eteq/magkeyboard/color_tests_inverted.png

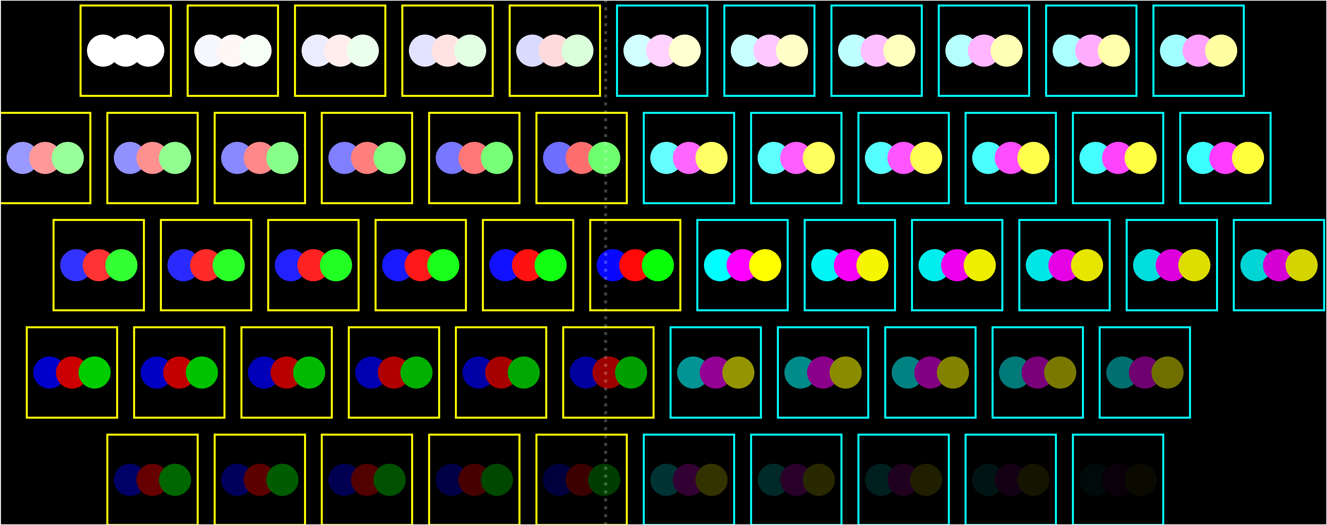
color_tests_inverted.png
