eteq/magkeyboard/color_tests.png

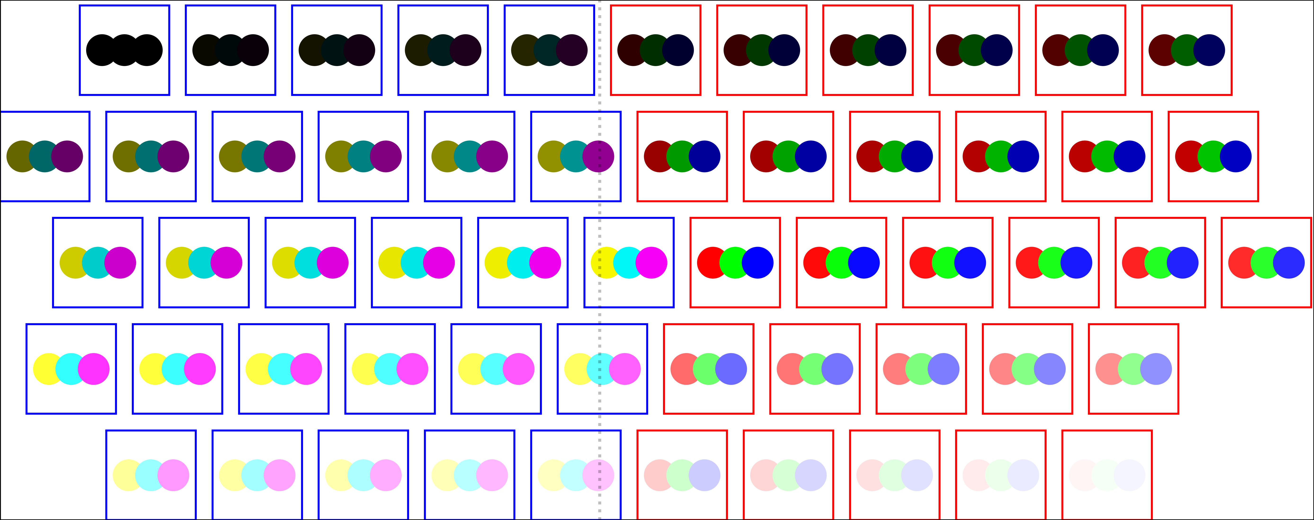
color_tests.png
