eteq/magkeyboard/keyboard_layout.png

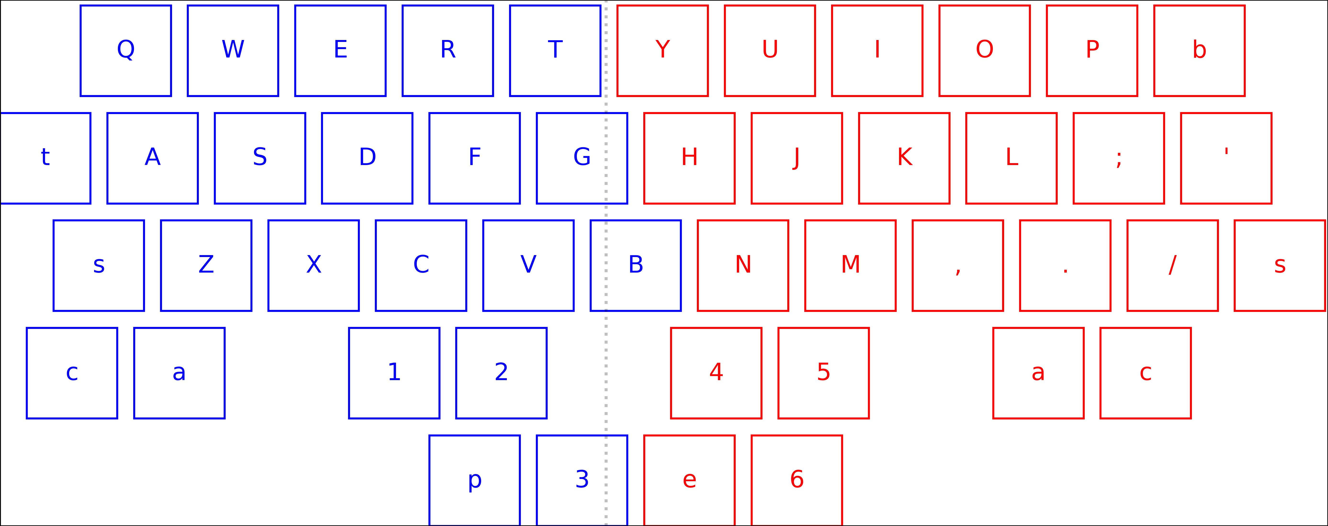
keyboard_layout.png
