eteq/magkeyboard/maghand/maghand.kicad_pcb

## KiCad design maghand/maghand.kicad_pcb (2025-11-02)

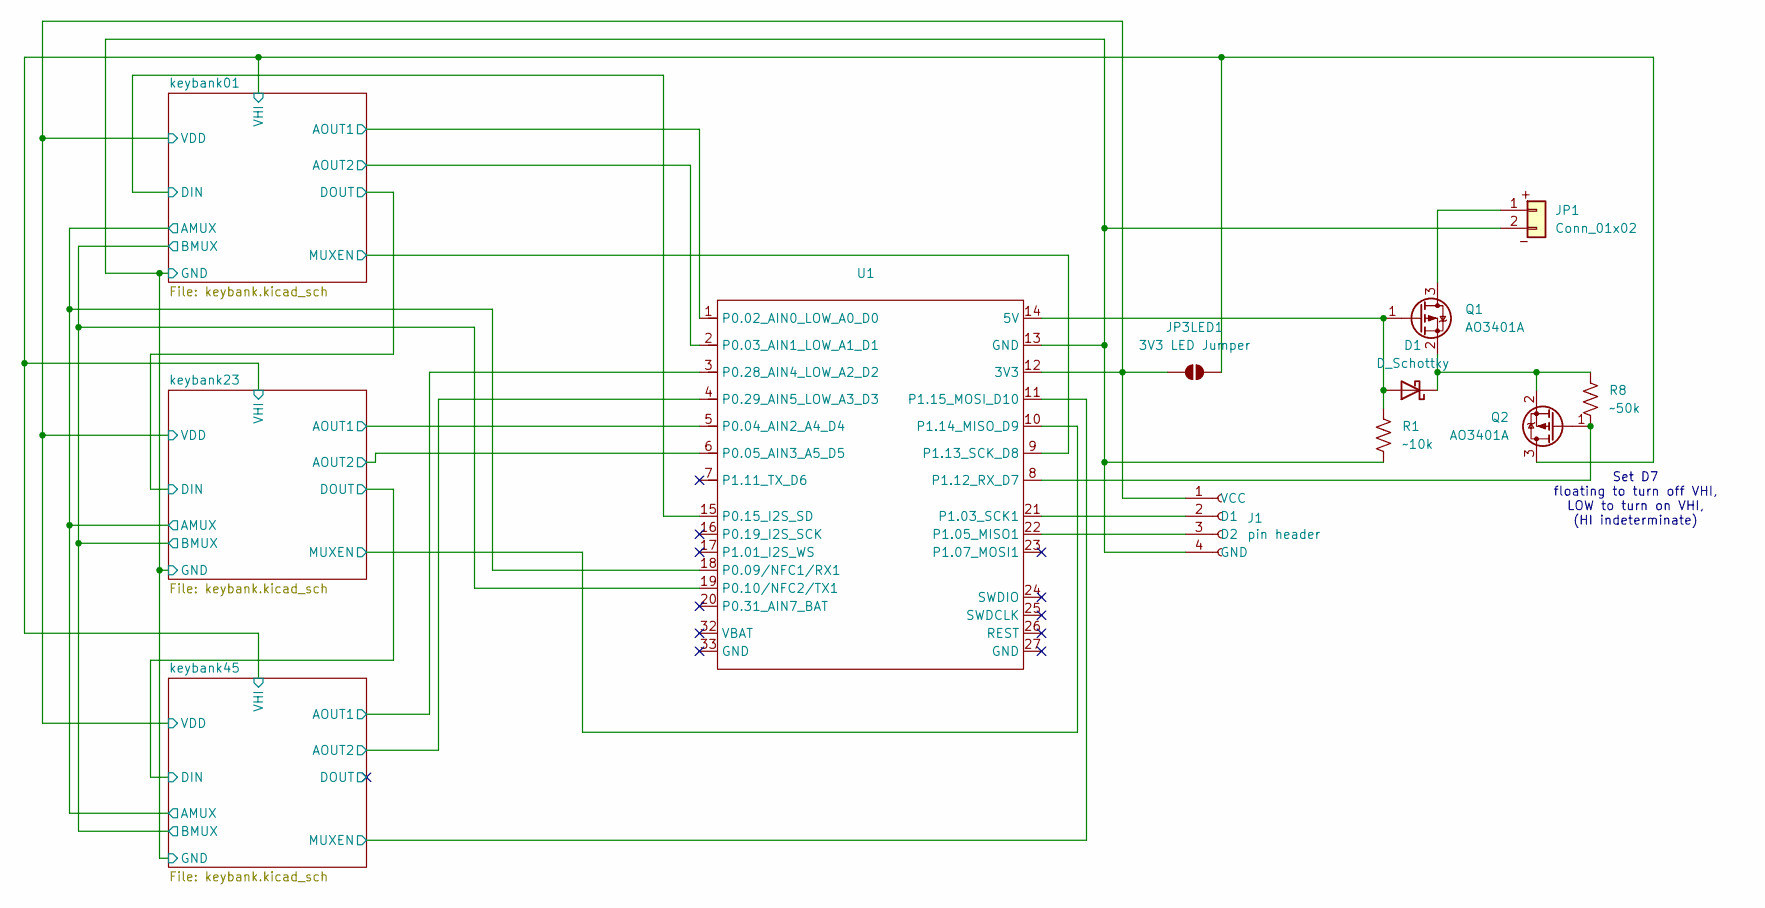
[picture p4: schematic maghand.kicad_sch]

Parts:
D1: D_Schottky; D_Powermite_AK
J1: pin header; PinSocket_1x04_P2.54mm_Vertical
JP1: Conn_01x02; JST_PH_S2B-PH-SM4-TB_1x02-1MP_P2.00mm_Horizontal
JP3LED1: 3V3 LED Jumper; SolderJumper-2_P1.3mm_Open_TrianglePad1.0x1.5mm
Q1, Q2: AO3401A; SOT-23
R1: ~10k; R_0805_2012Metric_Pad1.20x1.40mm_HandSolder
R8: ~50k; R_0805_2012Metric_Pad1.20x1.40mm_HandSolder
U1: XIAO-nRF52840-Plus-SMD_bathole

Connections:
/keybank01/AMUX: U1.18 (P0.09/NFC1/RX1); also elsewhere on the board
/keybank01/AOUT1: U1.1 (P0.02_AIN0_LOW_A0_D0); also elsewhere on the board
/keybank01/AOUT2: U1.2 (P0.03_AIN1_LOW_A1_D1); also elsewhere on the board
/keybank01/BMUX: U1.19 (P0.10/NFC2/TX1); also elsewhere on the board
/keybank01/DIN: U1.15 (P0.15_I2S_SD); also elsewhere on the board
/keybank01/GND: J1.4 (GND), JP1.2 (BAT-), R1.2, U1.13 (GND); also elsewhere on the board
/keybank01/MUXEN: U1.9 (P1.13_SCK_D8); also elsewhere on the board
/keybank01/VDD: J1.1 (VCC), JP3LED1.2 (B), U1.12 (3V3); also elsewhere on the board
/keybank01/VHI: JP3LED1.1 (A), Q2.3 (D); also elsewhere on the board
/keybank23/AOUT1: U1.5 (P0.04_AIN2_A4_D4); also elsewhere on the board
/keybank23/AOUT2: U1.6 (P0.05_AIN3_A5_D5); also elsewhere on the board
/keybank23/MUXEN: U1.10 (P1.14_MISO_D9); also elsewhere on the board
/keybank45/AOUT1: U1.3 (P0.28_AIN4_LOW_A2_D2); also elsewhere on the board
/keybank45/AOUT2: U1.4 (P0.29_AIN5_LOW_A3_D3); also elsewhere on the board
/keybank45/MUXEN: U1.11 (P1.15_MOSI_D10); also elsewhere on the board
unnamed: D1.2 (A), Q1.1 (G), R1.1, U1.14 (5V)
unnamed: D1.1 (K), Q1.2 (S), Q2.2 (S), R8.1
unnamed: J1.2 (D1), U1.21 (P1.03_SCK1)
unnamed: J1.3 (D2), U1.22 (P1.05_MISO1)
unnamed: JP1.1 (BAT+), Q1.3 (D)
unnamed: Q2.1 (G), R8.2, U1.8 (P1.12_RX_D7)

Notes on the sheet:
Set D7 floating to turn off VHI, LOW to turn on VHI, (HI indeterminate)

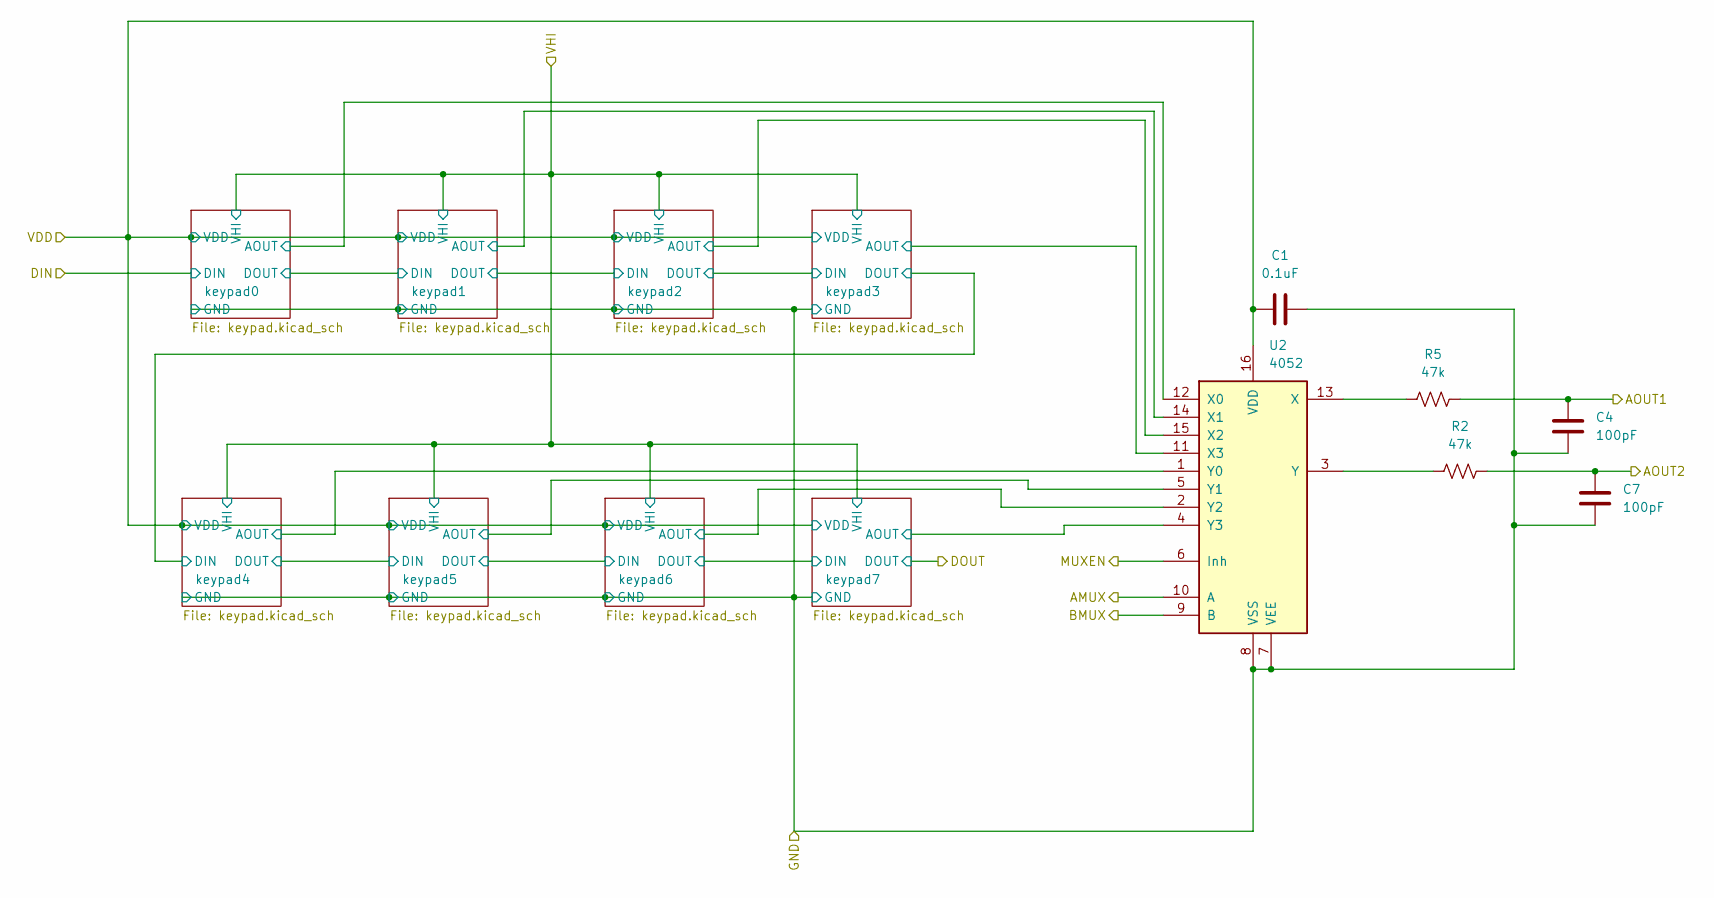
[picture p5: schematic keybank.kicad_sch, Key bank]

Parts:
C1: 0.1uF; C_0805_2012Metric_Pad1.18x1.45mm_HandSolder
C4, C7: 100pF; C_0805_2012Metric_Pad1.18x1.45mm_HandSolder
R2, R5: 47k; R_0805_2012Metric_Pad1.20x1.40mm_HandSolder
U2: 4052; SOIC-16_3.9x9.9mm_P1.27mm

Connections:
/keybank01/AMUX: U2.10 (A); also elsewhere on the board
/keybank01/AOUT1: C4.1, R5.2; also elsewhere on the board
/keybank01/AOUT2: C7.1, R2.2; also elsewhere on the board
/keybank01/BMUX: U2.9 (B); also elsewhere on the board
/keybank01/GND: C1.1, C4.2, C7.2, U2.7 (VEE), U2.8 (VSS); also elsewhere on the board
/keybank01/MUXEN: U2.6 (Inh); also elsewhere on the board
/keybank01/VDD: C1.2, U2.16 (VDD); also elsewhere on the board
/keybank01/keypad0/AOUT: U2.12 (X0); also elsewhere on the board
/keybank01/keypad1/AOUT: U2.14 (X1); also elsewhere on the board
/keybank01/keypad2/AOUT: U2.15 (X2); also elsewhere on the board
/keybank01/keypad3/AOUT: U2.11 (X3); also elsewhere on the board
/keybank01/keypad4/AOUT: U2.1 (Y0); also elsewhere on the board
/keybank01/keypad5/AOUT: U2.5 (Y1); also elsewhere on the board
/keybank01/keypad6/AOUT: U2.2 (Y2); also elsewhere on the board
/keybank01/keypad7/AOUT: U2.4 (Y3); also elsewhere on the board
unnamed: R5.1, U2.13 (X)
unnamed: R2.1, U2.3 (Y)

Parts of its further copies:
C2, C3: 0.1uF; C_0805_2012Metric_Pad1.18x1.45mm_HandSolder
C5, C6, C8, C9: 100pF; C_0805_2012Metric_Pad1.18x1.45mm_HandSolder
R3, R4, R6, R7: 47k; R_0805_2012Metric_Pad1.20x1.40mm_HandSolder
U3, U4: 4052; SOIC-16_3.9x9.9mm_P1.27mm

Connections of its further copies:
/keybank01/AMUX: U3.10 (A), U4.10 (A); also elsewhere on the board
/keybank01/BMUX: U3.9 (B), U4.9 (B); also elsewhere on the board
/keybank01/GND: C2.1, C3.1, C5.2, C6.2, C8.2, C9.2, U3.7 (VEE), U3.8 (VSS), U4.7 (VEE), U4.8 (VSS); also elsewhere on the board
/keybank01/VDD: C2.2, C3.2, U3.16 (VDD), U4.16 (VDD); also elsewhere on the board
/keybank23/AOUT1: C5.1, R6.2; also elsewhere on the board
/keybank23/AOUT2: C8.1, R3.2; also elsewhere on the board
/keybank23/MUXEN: U3.6 (Inh); also elsewhere on the board
/keybank23/keypad0/AOUT: U3.12 (X0); also elsewhere on the board
/keybank23/keypad1/AOUT: U3.14 (X1); also elsewhere on the board
/keybank23/keypad2/AOUT: U3.15 (X2); also elsewhere on the board
/keybank23/keypad3/AOUT: U3.11 (X3); also elsewhere on the board
/keybank23/keypad4/AOUT: U3.1 (Y0); also elsewhere on the board
/keybank23/keypad5/AOUT: U3.5 (Y1); also elsewhere on the board
/keybank23/keypad6/AOUT: U3.2 (Y2); also elsewhere on the board
/keybank23/keypad7/AOUT: U3.4 (Y3); also elsewhere on the board
/keybank45/AOUT1: C6.1, R7.2; also elsewhere on the board
/keybank45/AOUT2: C9.1, R4.2; also elsewhere on the board
/keybank45/MUXEN: U4.6 (Inh); also elsewhere on the board
/keybank45/keypad0/AOUT: U4.12 (X0); also elsewhere on the board
/keybank45/keypad1/AOUT: U4.14 (X1); also elsewhere on the board
/keybank45/keypad2/AOUT: U4.15 (X2); also elsewhere on the board
/keybank45/keypad3/AOUT: U4.11 (X3); also elsewhere on the board
/keybank45/keypad4/AOUT: U4.1 (Y0); also elsewhere on the board
/keybank45/keypad5/AOUT: U4.5 (Y1); also elsewhere on the board
/keybank45/keypad6/AOUT: U4.2 (Y2); also elsewhere on the board
/keybank45/keypad7/AOUT: U4.4 (Y3)
unnamed: R6.1, U3.13 (X)
unnamed: R3.1, U3.3 (Y)
unnamed: R7.1, U4.13 (X)
unnamed: R4.1, U4.3 (Y)

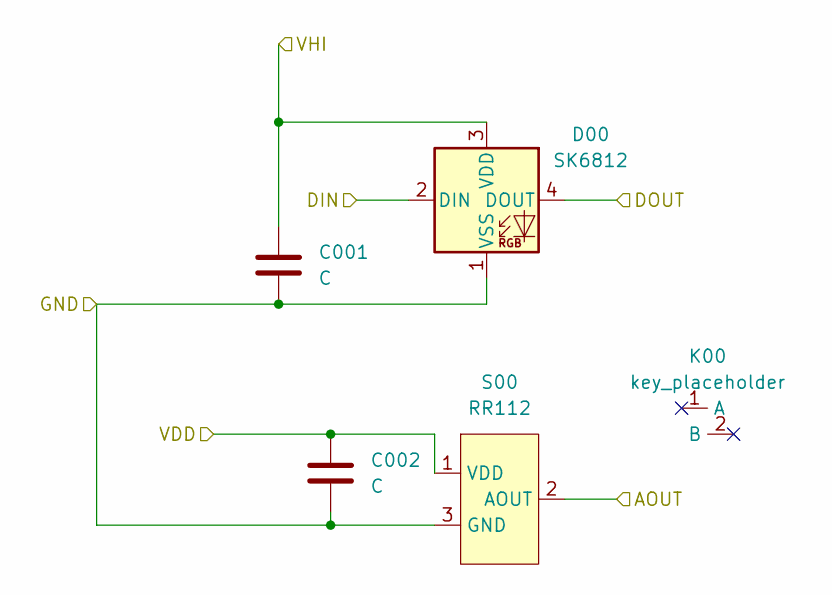
[picture p6: schematic keypad.kicad_sch, key subschematic]

Parts:
C001, C002: C; C_0805_2012Metric_Pad1.18x1.45mm_HandSolder
D00: SK6812; LED_SK6812_PLCC4_5.0x5.0mm_P3.2mm
K00: key_placeholder; Key Holder
S00: RR112; SOT-23_Handsoldering

Connections:
/keybank01/DIN: D00.2 (DIN); also elsewhere on the board
/keybank01/GND: C001.2, C002.2, D00.1 (VSS), S00.3 (GND); also elsewhere on the board
/keybank01/VDD: C002.1, S00.1 (VDD); also elsewhere on the board
/keybank01/VHI: C001.1, D00.3 (VDD); also elsewhere on the board
/keybank01/keypad0/AOUT: S00.2 (AOUT); also elsewhere on the board
/keybank01/keypad0/DOUT: D00.4 (DOUT); also elsewhere on the board

Parts of its further copies:
C011, C012, C021, C022, C031, C032, C101, C102, C111, C112, C121, C122, C131, C132, C201, C202, C211, C212, C221, C222, C231, C232, C301, C302, C311, C312, C321, C322, C331, C332, C401, C402, C411, C412, C421, C422, C431, C432, C501, C502, C511, C512, C521, C522: C; C_0805_2012Metric_Pad1.18x1.45mm_HandSolder
D01, D02, D03, D10, D11, D12, D13, D20, D21, D22, D23, D30, D31, D32, D33, D40, D41, D42, D43, D50, D51, D52: SK6812; LED_SK6812_PLCC4_5.0x5.0mm_P3.2mm
K01, K02, K03, K10, K11, K12, K13, K20, K21, K22, K23, K30, K31, K32, K33, K40, K41, K42, K43, K50, K51, K52: key_placeholder; Key Holder
S01, S02, S03, S10, S11, S12, S13, S20, S21, S22, S23, S30, S31, S32, S33, S40, S41, S42, S43, S50, S51, S52: RR112; SOT-23_Handsoldering

Connections of its further copies:
/keybank01/DOUT: D13.4 (DOUT), D20.2 (DIN)
/keybank01/GND: C011.2, C012.2, C021.2, C022.2, C031.2, C032.2, C101.2, C102.2, C111.2, C112.2, C121.2, C122.2, C131.2, C132.2, C201.2, C202.2, C211.2, C212.2, C221.2, C222.2, C231.2, C232.2, C301.2, C302.2, C311.2, C312.2, C321.2, C322.2, C331.2, C332.2, C401.2, C402.2, C411.2, C412.2, C421.2, C422.2, C431.2, C432.2, C501.2, C502.2, C511.2, C512.2, C521.2, C522.2, D01.1 (VSS), D02.1 (VSS), D03.1 (VSS), D10.1 (VSS), D11.1 (VSS), D12.1 (VSS), D13.1 (VSS), D20.1 (VSS), D21.1 (VSS), D22.1 (VSS), D23.1 (VSS), D30.1 (VSS), D31.1 (VSS), D32.1 (VSS), D33.1 (VSS), D40.1 (VSS), D41.1 (VSS), D42.1 (VSS), D43.1 (VSS), D50.1 (VSS), D51.1 (VSS), D52.1 (VSS), S01.3 (GND), S02.3 (GND), S03.3 (GND), S10.3 (GND), S11.3 (GND), S12.3 (GND), S13.3 (GND), S20.3 (GND), S21.3 (GND), S22.3 (GND), S23.3 (GND), S30.3 (GND), S31.3 (GND), S32.3 (GND), S33.3 (GND), S40.3 (GND), S41.3 (GND), S42.3 (GND), S43.3 (GND), S50.3 (GND), S51.3 (GND), S52.3 (GND); also elsewhere on the board
/keybank01/VDD: C012.1, C022.1, C032.1, C102.1, C112.1, C122.1, C132.1, C202.1, C212.1, C222.1, C232.1, C302.1, C312.1, C322.1, C332.1, C402.1, C412.1, C422.1, C432.1, C502.1, C512.1, C522.1, S01.1 (VDD), S02.1 (VDD), S03.1 (VDD), S10.1 (VDD), S11.1 (VDD), S12.1 (VDD), S13.1 (VDD), S20.1 (VDD), S21.1 (VDD), S22.1 (VDD), S23.1 (VDD), S30.1 (VDD), S31.1 (VDD), S32.1 (VDD), S33.1 (VDD), S40.1 (VDD), S41.1 (VDD), S42.1 (VDD), S43.1 (VDD), S50.1 (VDD), S51.1 (VDD), S52.1 (VDD); also elsewhere on the board
/keybank01/VHI: C011.1, C021.1, C031.1, C101.1, C111.1, C121.1, C131.1, C201.1, C211.1, C221.1, C231.1, C301.1, C311.1, C321.1, C331.1, C401.1, C411.1, C421.1, C431.1, C501.1, C511.1, C521.1, D01.3 (VDD), D02.3 (VDD), D03.3 (VDD), D10.3 (VDD), D11.3 (VDD), D12.3 (VDD), D13.3 (VDD), D20.3 (VDD), D21.3 (VDD), D22.3 (VDD), D23.3 (VDD), D30.3 (VDD), D31.3 (VDD), D32.3 (VDD), D33.3 (VDD), D40.3 (VDD), D41.3 (VDD), D42.3 (VDD), D43.3 (VDD), D50.3 (VDD), D51.3 (VDD), D52.3 (VDD); also elsewhere on the board
/keybank01/keypad0/DOUT: D01.2 (DIN); also elsewhere on the board
/keybank01/keypad1/AOUT: S01.2 (AOUT); also elsewhere on the board
/keybank01/keypad1/DOUT: D01.4 (DOUT), D02.2 (DIN)
/keybank01/keypad2/AOUT: S02.2 (AOUT); also elsewhere on the board
/keybank01/keypad2/DOUT: D02.4 (DOUT), D03.2 (DIN)
/keybank01/keypad3/AOUT: S03.2 (AOUT); also elsewhere on the board
/keybank01/keypad3/DOUT: D03.4 (DOUT), D10.2 (DIN)
/keybank01/keypad4/AOUT: S10.2 (AOUT); also elsewhere on the board
/keybank01/keypad4/DOUT: D10.4 (DOUT), D11.2 (DIN)
/keybank01/keypad5/AOUT: S11.2 (AOUT); also elsewhere on the board
/keybank01/keypad5/DOUT: D11.4 (DOUT), D12.2 (DIN)
/keybank01/keypad6/AOUT: S12.2 (AOUT); also elsewhere on the board
/keybank01/keypad6/DOUT: D12.4 (DOUT), D13.2 (DIN)
/keybank01/keypad7/AOUT: S13.2 (AOUT); also elsewhere on the board
/keybank23/DOUT: D33.4 (DOUT), D40.2 (DIN)
/keybank23/keypad0/AOUT: S20.2 (AOUT); also elsewhere on the board
/keybank23/keypad0/DOUT: D20.4 (DOUT), D21.2 (DIN)
/keybank23/keypad1/AOUT: S21.2 (AOUT); also elsewhere on the board
/keybank23/keypad1/DOUT: D21.4 (DOUT), D22.2 (DIN)
/keybank23/keypad2/AOUT: S22.2 (AOUT); also elsewhere on the board
/keybank23/keypad2/DOUT: D22.4 (DOUT), D23.2 (DIN)
/keybank23/keypad3/AOUT: S23.2 (AOUT); also elsewhere on the board
/keybank23/keypad3/DOUT: D23.4 (DOUT), D30.2 (DIN)
/keybank23/keypad4/AOUT: S30.2 (AOUT); also elsewhere on the board
/keybank23/keypad4/DOUT: D30.4 (DOUT), D31.2 (DIN)
/keybank23/keypad5/AOUT: S31.2 (AOUT); also elsewhere on the board
/keybank23/keypad5/DOUT: D31.4 (DOUT), D32.2 (DIN)
/keybank23/keypad6/AOUT: S32.2 (AOUT); also elsewhere on the board
/keybank23/keypad6/DOUT: D32.4 (DOUT), D33.2 (DIN)
/keybank23/keypad7/AOUT: S33.2 (AOUT); also elsewhere on the board
/keybank45/keypad0/AOUT: S40.2 (AOUT); also elsewhere on the board
/keybank45/keypad0/DOUT: D40.4 (DOUT), D41.2 (DIN)
/keybank45/keypad1/AOUT: S41.2 (AOUT); also elsewhere on the board
/keybank45/keypad1/DOUT: D41.4 (DOUT), D42.2 (DIN)
/keybank45/keypad2/AOUT: S42.2 (AOUT); also elsewhere on the board
/keybank45/keypad2/DOUT: D42.4 (DOUT), D43.2 (DIN)
/keybank45/keypad3/AOUT: S43.2 (AOUT); also elsewhere on the board
/keybank45/keypad3/DOUT: D43.4 (DOUT), D50.2 (DIN)
/keybank45/keypad4/AOUT: S50.2 (AOUT); also elsewhere on the board
/keybank45/keypad4/DOUT: D50.4 (DOUT), D51.2 (DIN)
/keybank45/keypad5/AOUT: S51.2 (AOUT); also elsewhere on the board
/keybank45/keypad5/DOUT: D51.4 (DOUT), D52.2 (DIN)
/keybank45/keypad6/AOUT: S52.2 (AOUT); also elsewhere on the board
/keybank45/keypad6/DOUT: D52.4 (DOUT)

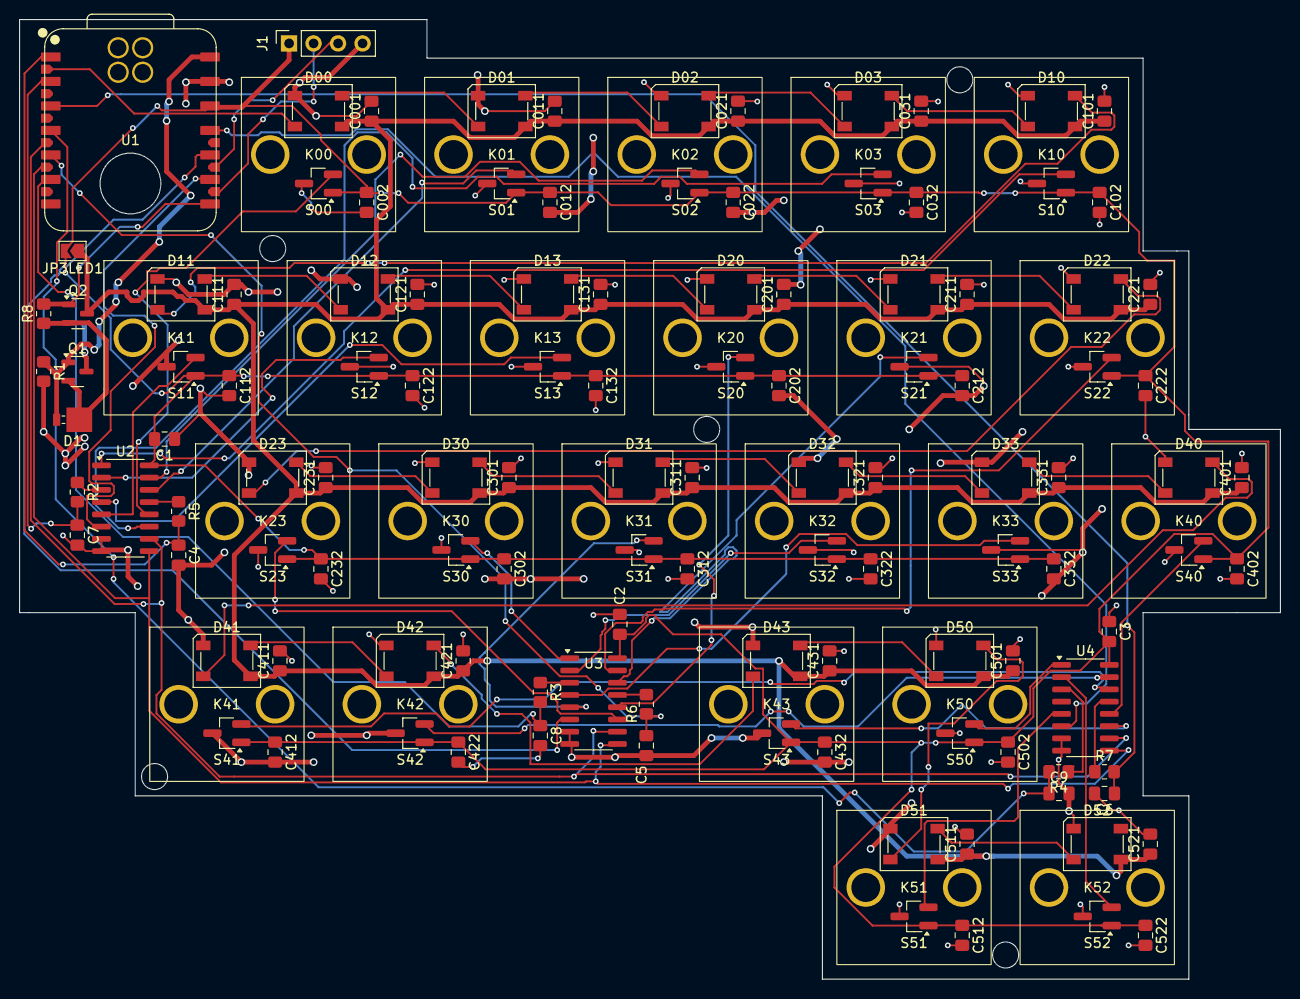
[picture p7: board maghand.kicad_pcb from above]

Board: 2 copper layers, 130.8 x 99.5 mm, 142 parts (1 on the bottom side), 72 nets.
