eteq/magkeyboard/(commit log)

2025-11-02 add pcb
    [keybank.kicad_sch, keypad.kicad_sch, maghand.csv, maghand.kicad_pcb, maghand.kicad_sch]
2026-01-11 add sense board led setter
2026-01-11 working spi-driven leds
2026-01-11 working imu
2026-01-12 add gyro
2026-01-12 power notes
2026-01-13 testing adc multi-channel reading
2026-01-26 added important missing files!
    [hardware_consts.rs, keys.rs]
2026-01-28 add optional adc printing feature
2026-01-30 switched to pubsub instead of channel
2026-02-07 add some power testing bits
